GHF/corntroller-hw/TODO/todo.txt

TODO
====

4/16/2012
---------
+ fix PWM input labels

4/05/2012
---------
+ need more:
	10k 0603
	4.7uF 0603 >=10V
	4.7k 0603
	9.1k 0603
	ACS714

3/27/2012
---------
+ update board docs & art
+ panelize TinyHusk

3/20/2012
---------
schematic fixes:
+ remove MAX881R
+ remove current sense op amps; just use a divider (9.1k & 4.7k)
+ add NC trace jumper for DVDD to REF
+ widen DRV8302 footprint

3/17/2012
---------
tinyhusk v2.0:
+ airwire MAX881R pin 7 to -UB
+ fix inverting amps into buffers
+ replace (1k + 1k) & 330R divider with (10k + 10k) & 10k
+ bridge DVDD to REF
+ check all DRV8302 joints

minicob v2.0:
+ desolder radio, solder in bluetooth
