GHF/corntroller-hw/MiniCob/babycorntroller.bmp

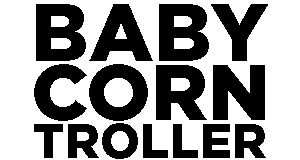
MiniCob/babycorntroller.bmp
