GHF/corntroller-hw/MiniCob/vanity.bmp

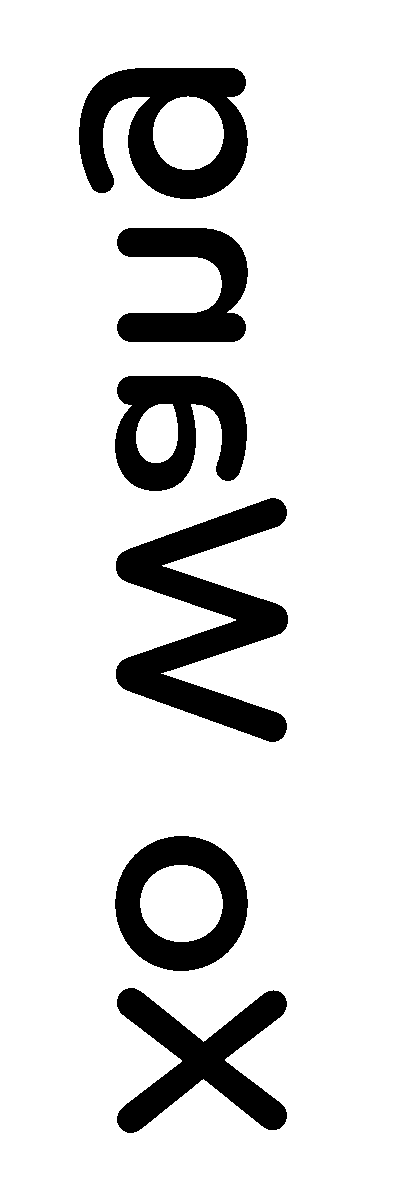
MiniCob/vanity.bmp
