GHF/corntroller-hw/TinyHusk/babycorntroller.bmp

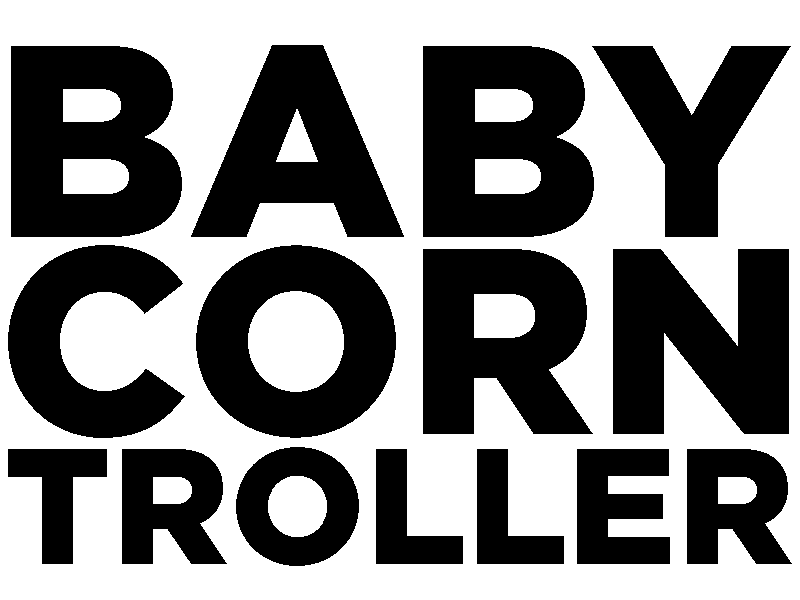
TinyHusk/babycorntroller.bmp
