GHF/corntroller-hw/TODO/negLDOfix.png

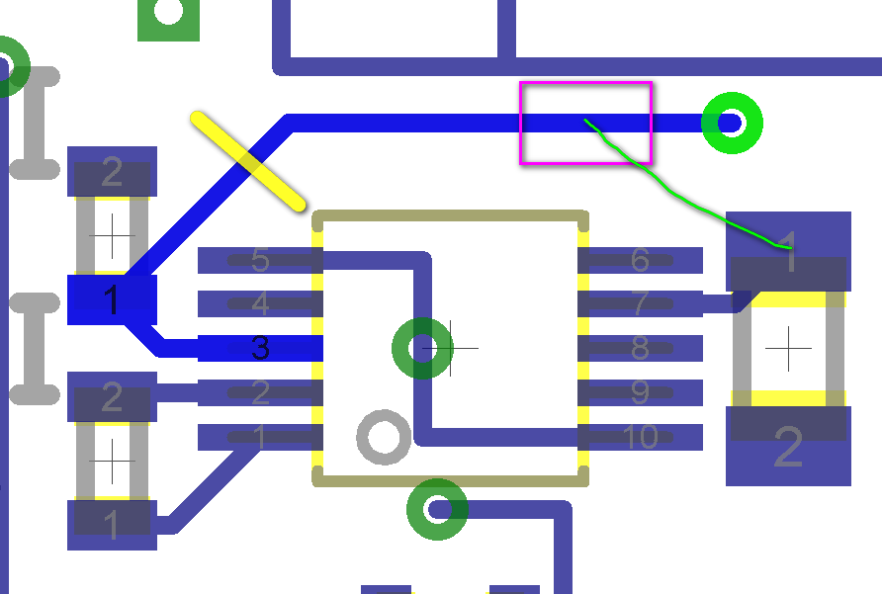
TODO/negLDOfix.png
