GHF/corntroller-hw/TODO/opAmpFix.png

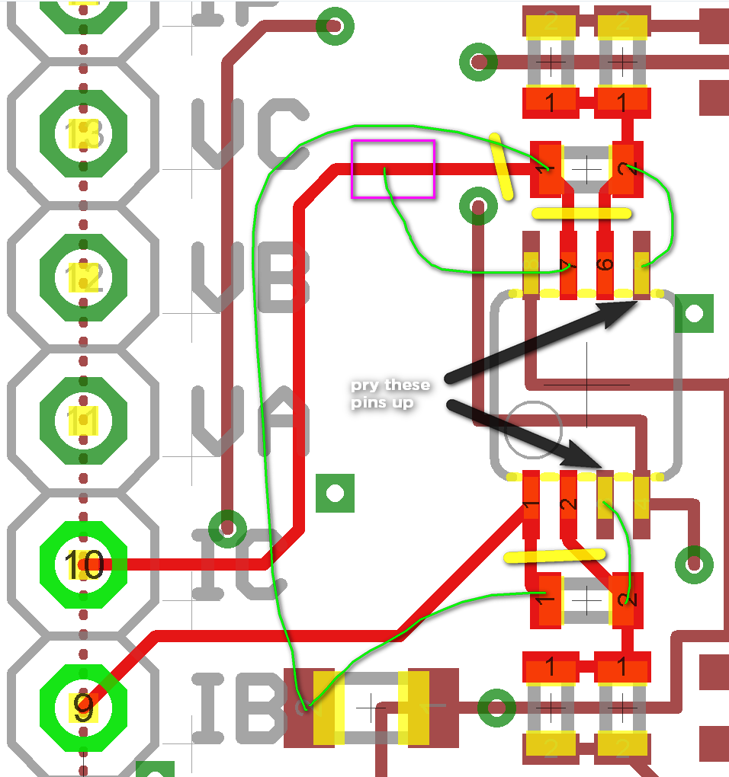
TODO/opAmpFix.png
