GHF/corntroller-hw/TODO/radioFootprint.png

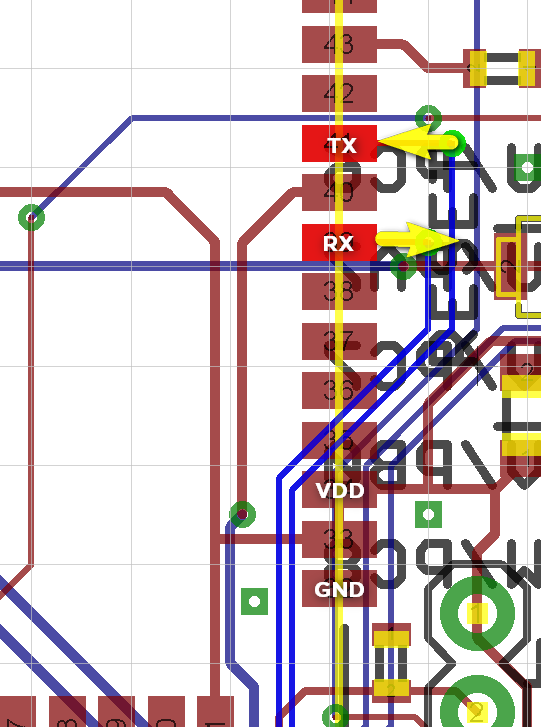
TODO/radioFootprint.png
