GHF/corntroller-hw/TinyHusk/TinyHusk.brd

## EAGLE design TinyHusk/TinyHusk.brd (2012-04-16)

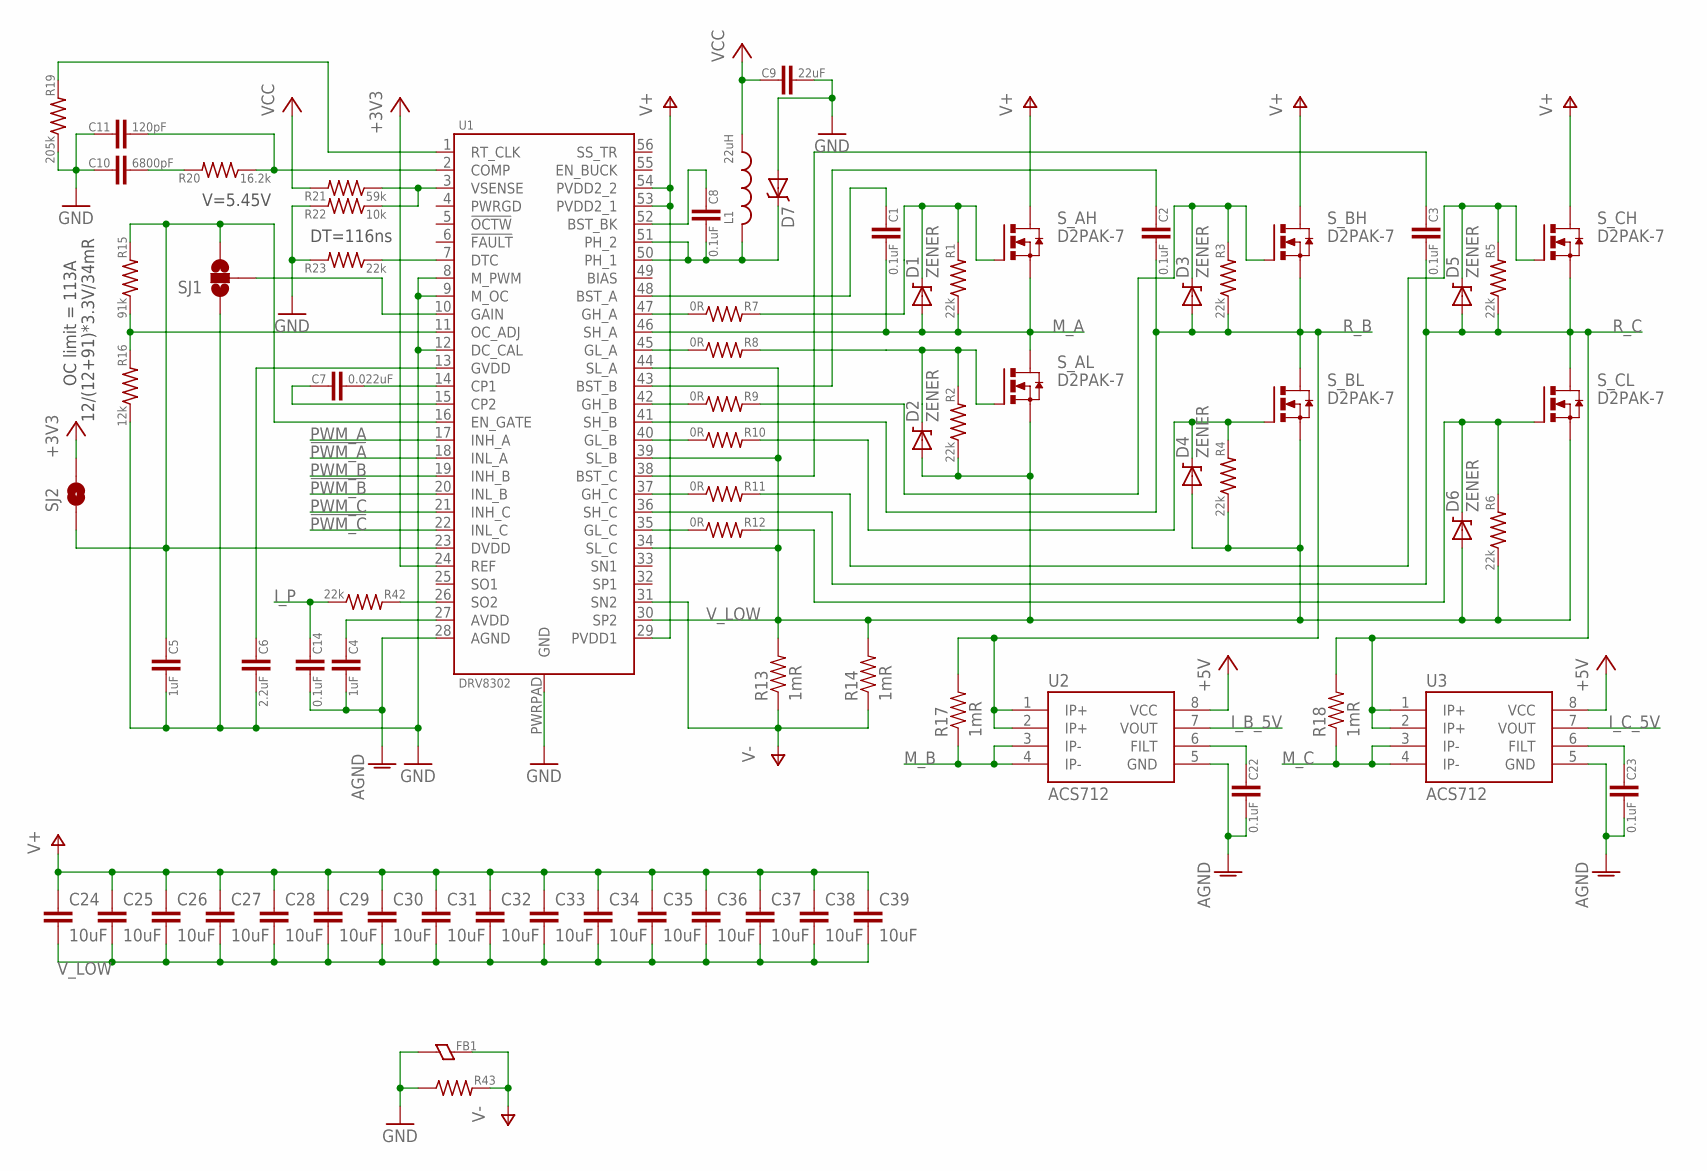
[picture p7: schematic TinyHusk.sch, sheet 1]

Parts:
C1, C2, C3, C8, C14, C22, C23: 0.1uF; 0603
C4, C5: 1uF; 0603
C6: 2.2uF; 0603
C7: 0.022uF; 0603
C9: 22uF; 0805
C10: 6800pF; 0603
C11: 120pF; 0603
C24, C25, C26, C27, C28, C29, C30, C31, C32, C33, C34, C35, C36, C37, C38, C39: 10uF; 1210
D1, D2, D3, D4, D5, D6: ZENER; SOD-323
D7: DIODE-SCHOTTKY_; SMA-DIODE
FB1: FERRITE0603; 0603
L1: 22uH; TAIYO-YUDEN_NR50
R1, R2, R3, R4, R5, R6, R23, R42: 22k; 0603
R7, R8, R9, R10, R11, R12: 0R; 0603
R13, R14, R17, R18: 1mR; R2512
R15: 91k; 0603
R16: 12k; 0603
R19: 205k; 0603
R20: 16.2k; 0603
R21: 59k; 0603
R22: 10k; 0603
R43: R0603; 0603
SJ1: SOLDERJUMPER_2WAYS; SJ_X
SJ2: SOLDERJUMPERTRACE; SJ_2S-TRACE
S_AH: D2PAK-7
S_AL: D2PAK-7
S_BH: D2PAK-7
S_BL: D2PAK-7
S_CH: D2PAK-7
S_CL: D2PAK-7
U1: DRV8302; HTSSOP-56
U2, U3: ACS712; SO08

Connections:
!PWM_A: U1.18 (INL_A); also elsewhere on the board
!PWM_B: U1.20 (INL_B); also elsewhere on the board
!PWM_C: U1.22 (INL_C); also elsewhere on the board
+3V3: SJ2.2, U1.24 (REF); also elsewhere on the board
+5V: U2.8 (VCC), U3.8 (VCC); also elsewhere on the board
AGND: C4.2, C14.2, C22.2, C23.2, U1.28 (AGND), U2.5 (GND), U3.5 (GND); also elsewhere on the board
GND: C5.2, C6.2, C9.2, C10.1, C11.1, D7.A, FB1.1, R16.1, R19.1, R22.2, R23.2, R43.1, SJ1.1, U1.8 (M_PWM), U1.9 (M_OC), U1.12 (DC_CAL), U1.PWRPAD (GND); also elsewhere on the board
I_B_5V: U2.7 (VOUT); also elsewhere on the board
I_C_5V: U3.7 (VOUT); also elsewhere on the board
I_P: C14.1, R42.1; also elsewhere on the board
M_A: C1.2, D1.2 (A), R1.1, S_AH.2 (S), S_AH.3 (S), S_AH.5 (S), S_AH.6 (S), S_AH.7 (S), S_AL.4 (D), U1.46 (SH_A); also elsewhere on the board
M_B: R17.1, U2.3 (IP-), U2.4 (IP-)
M_C: R18.1, U3.3 (IP-), U3.4 (IP-)
unnamed: R7.1, U1.47 (GH_A)
unnamed: R8.1, U1.45 (GL_A)
unnamed: R42.2, U1.26 (SO2)
unnamed: D1.1 (C), R1.2, R7.2, S_AH.1 (G)
unnamed: D3.1 (C), R3.2, R9.2, S_BH.1 (G)
unnamed: C22.1, U2.6 (FILT)
unnamed: D4.1 (C), R4.2, R10.2, S_BL.1 (G)
unnamed: R21.1, R22.1, U1.3 (VSENSE)
unnamed: D5.1 (C), R5.2, R11.2, S_CH.1 (G)
unnamed: C23.1, U3.6 (FILT)
unnamed: D6.1 (C), R6.2, R12.2, S_CL.1 (G)
unnamed: R9.1, U1.42 (GH_B)
unnamed: C1.1, U1.48 (BST_A)
unnamed: C2.1, U1.43 (BST_B)
unnamed: C3.1, U1.38 (BST_C)
unnamed: R10.1, U1.40 (GL_B)
unnamed: R11.1, U1.37 (GH_C)
unnamed: D2.1 (C), R2.2, R8.2, S_AL.1 (G)
unnamed: R12.1, U1.35 (GL_C)
unnamed: SJ1.2, U1.10 (GAIN)
unnamed: C5.1, R15.2, SJ1.3, SJ2.1, U1.16 (EN_GATE), U1.23 (DVDD)
unnamed: C4.1, U1.27 (AVDD)
unnamed: C6.1, U1.13 (GVDD)
unnamed: C7.2, U1.14 (CP1)
unnamed: C7.1, U1.15 (CP2)
unnamed: R15.1, R16.2, U1.11 (OC_ADJ)
unnamed: C8.2, D7.C, L1.P$2 (2), U1.50 (PH_1), U1.51 (PH_2)
unnamed: C8.1, U1.52 (BST_BK)
unnamed: C11.2, R20.1, U1.2 (COMP)
unnamed: C10.2, R20.2
unnamed: R19.2, U1.1 (RT_CLK)
unnamed: R23.1, U1.7 (DTC)
PWM_A: U1.17 (INH_A); also elsewhere on the board
PWM_B: U1.19 (INH_B); also elsewhere on the board
PWM_C: U1.21 (INH_C); also elsewhere on the board
R_B: C2.2, D3.2 (A), R3.1, R17.2, S_BH.2 (S), S_BH.3 (S), S_BH.5 (S), S_BH.6 (S), S_BH.7 (S), S_BL.4 (D), U1.41 (SH_B), U2.1 (IP+), U2.2 (IP+); also elsewhere on the board
R_C: C3.2, D5.2 (A), R5.1, R18.2, S_CH.2 (S), S_CH.3 (S), S_CH.5 (S), S_CH.6 (S), S_CH.7 (S), S_CL.4 (D), U1.36 (SH_C), U3.1 (IP+), U3.2 (IP+); also elsewhere on the board
V+: C24.1, C25.1, C26.1, C27.1, C28.1, C29.1, C30.1, C31.1, C32.1, C33.1, C34.1, C35.1, C36.1, C37.1, C38.1, C39.1, S_AH.4 (D), S_BH.4 (D), S_CH.4 (D), U1.29 (PVDD1), U1.53 (PVDD2_1), U1.54 (PVDD2_2); also elsewhere on the board
V-: FB1.2, R13.1, R14.1, R43.2, U1.31 (SN2); also elsewhere on the board
VCC: C9.1, L1.P$1 (1), R21.2; also elsewhere on the board
V_LOW: C24.2, C25.2, C26.2, C27.2, C28.2, C29.2, C30.2, C31.2, C32.2, C33.2, C34.2, C35.2, C36.2, C37.2, C38.2, C39.2, D2.2 (A), D4.2 (A), D6.2 (A), R2.1, R4.1, R6.1, R13.2, R14.2, S_AL.2 (S), S_AL.3 (S), S_AL.5 (S), S_AL.6 (S), S_AL.7 (S), S_BL.2 (S), S_BL.3 (S), S_BL.5 (S), S_BL.6 (S), S_BL.7 (S), S_CL.2 (S), S_CL.3 (S), S_CL.5 (S), S_CL.6 (S), S_CL.7 (S), U1.30 (SP2), U1.34 (SL_C), U1.39 (SL_B), U1.44 (SL_A)

Notes on the sheet:
OC limit = 113A
12/(12+91)*3.3V/34mR
V=5.45V
DT=116ns

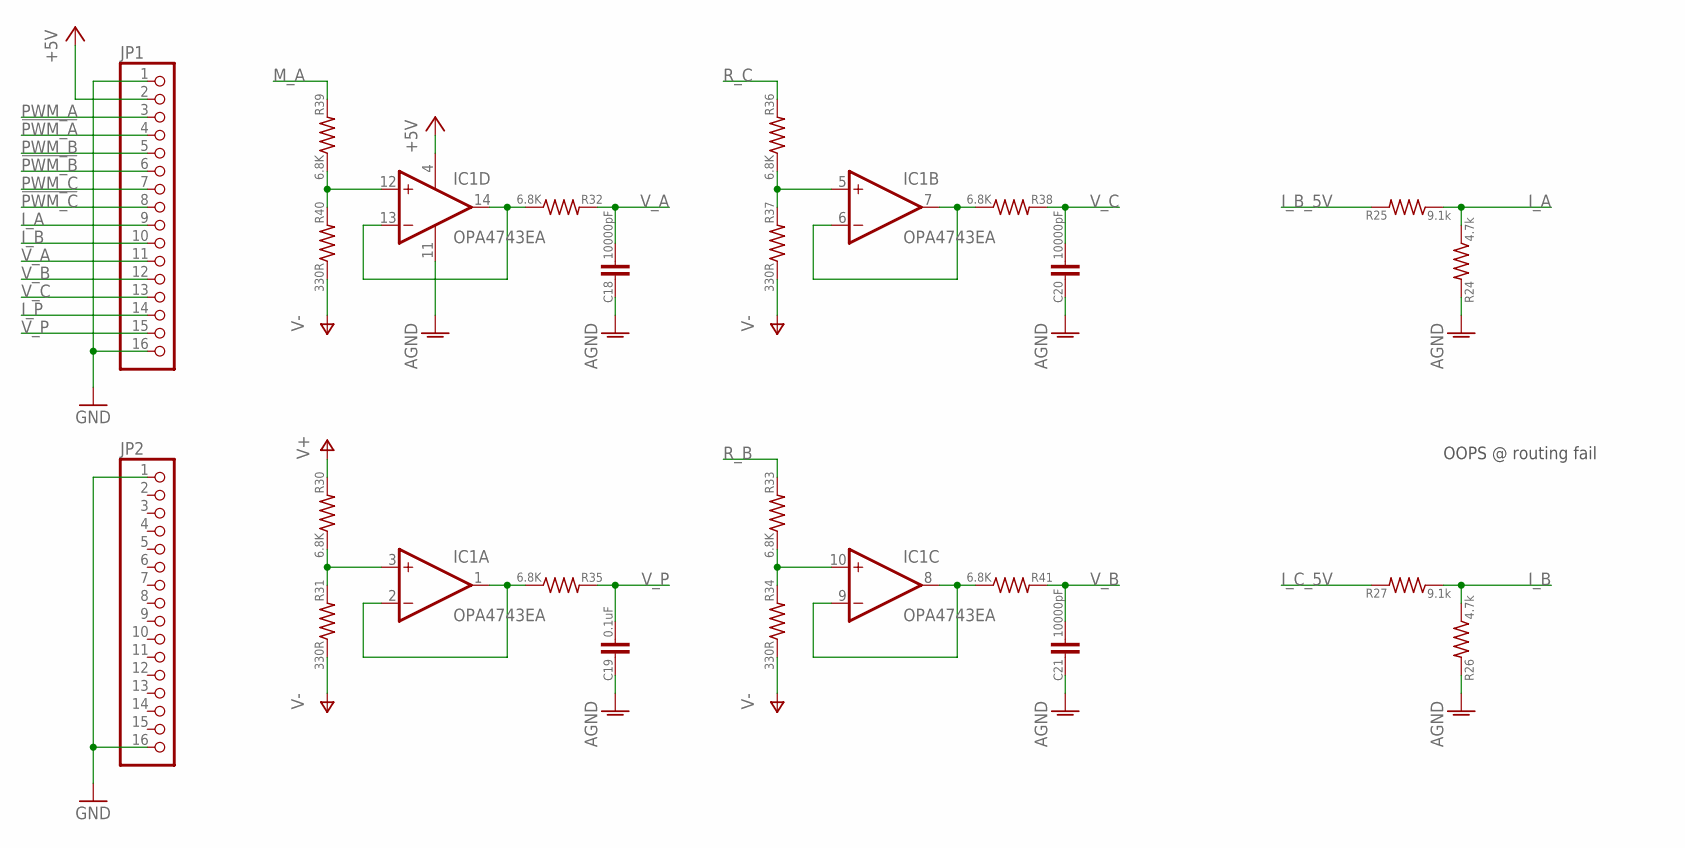
[picture p8: schematic TinyHusk.sch, sheet 2]

Parts:
C18, C20, C21: 10000pF; 0603
C19: 0.1uF; 0603
IC1: OPA4743EA; TSSOP14
JP1, JP2: PINHD-1X16_2.54-S; 1X16-S
R24, R26: 4.7k; 0603
R25, R27: 9.1k; 0603
R30, R32, R33, R35, R36, R38, R39, R41: 6.8K; 0603
R31, R34, R37, R40: 330R; 0603

Connections:
!PWM_A: JP1.4; also elsewhere on the board
!PWM_B: JP1.6; also elsewhere on the board
!PWM_C: JP1.8; also elsewhere on the board
+5V: IC1.4 (V+), JP1.2; also elsewhere on the board
AGND: C18.1, C19.1, C20.1, C21.1, IC1.11 (V-), R24.2, R26.2; also elsewhere on the board
GND: JP1.1, JP1.16, JP2.1, JP2.16; also elsewhere on the board
I_A: JP1.9, R24.1, R25.1
I_B: JP1.10, R26.1, R27.1
I_B_5V: R25.2; also elsewhere on the board
I_C_5V: R27.2; also elsewhere on the board
I_P: JP1.14; also elsewhere on the board
M_A: R39.2; also elsewhere on the board
unnamed: IC1.1 (OUT), IC1.2 (-IN), R35.1
unnamed: IC1.6 (-IN), IC1.7 (OUT), R38.1
unnamed: IC1.8 (OUT), IC1.9 (-IN), R41.1
unnamed: IC1.13 (-IN), IC1.14 (OUT), R32.1
unnamed: IC1.3 (+IN), R30.1, R31.2
unnamed: IC1.10 (+IN), R33.1, R34.2
unnamed: IC1.5 (+IN), R36.1, R37.2
unnamed: IC1.12 (+IN), R39.1, R40.2
PWM_A: JP1.3; also elsewhere on the board
PWM_B: JP1.5; also elsewhere on the board
PWM_C: JP1.7; also elsewhere on the board
R_B: R33.2; also elsewhere on the board
R_C: R36.2; also elsewhere on the board
V+: R30.2; also elsewhere on the board
V-: R31.1, R34.1, R37.1, R40.1; also elsewhere on the board
V_A: C18.2, JP1.11, R32.2
V_B: C21.2, JP1.12, R41.2
V_C: C20.2, JP1.13, R38.2
V_P: C19.2, JP1.15, R35.2

Notes on the sheet:
OOPS @ routing fail

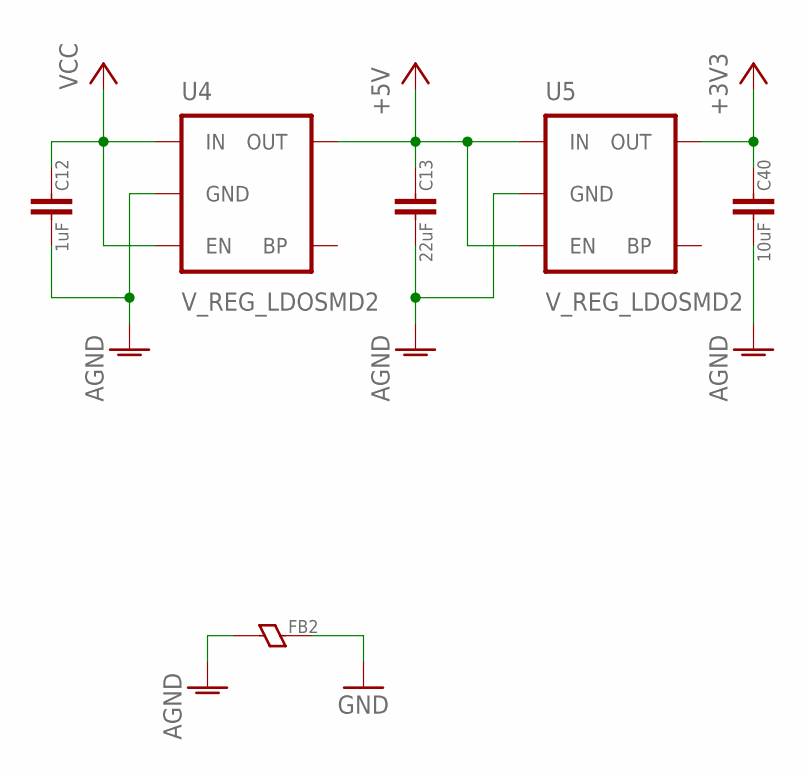
[picture p9: schematic TinyHusk.sch, sheet 3]

Parts:
C12: 1uF; 0603
C13: 22uF; 0805
C40: 10uF; 0603
FB2: FERRITE0603; 0603
U4, U5: V_REG_LDOSMD2; SC70

Connections:
+3V3: C40.1, U5.5 (OUT); also elsewhere on the board
+5V: C13.1, U4.5 (OUT), U5.1 (IN), U5.3 (EN); also elsewhere on the board
AGND: C12.2, C13.2, C40.2, FB2.1, U4.2 (GND), U5.2 (GND); also elsewhere on the board
GND: FB2.2; also elsewhere on the board
VCC: C12.1, U4.1 (IN), U4.3 (EN); also elsewhere on the board

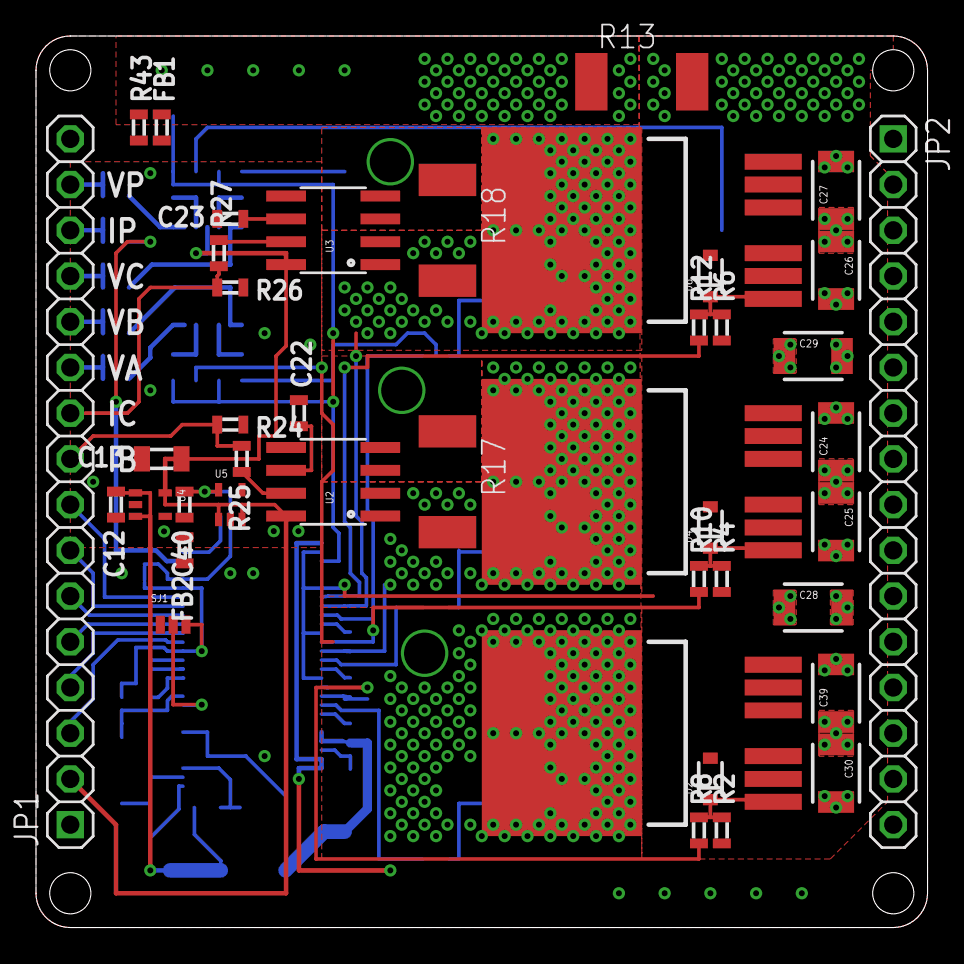
[picture p10: board TinyHusk.brd from above]

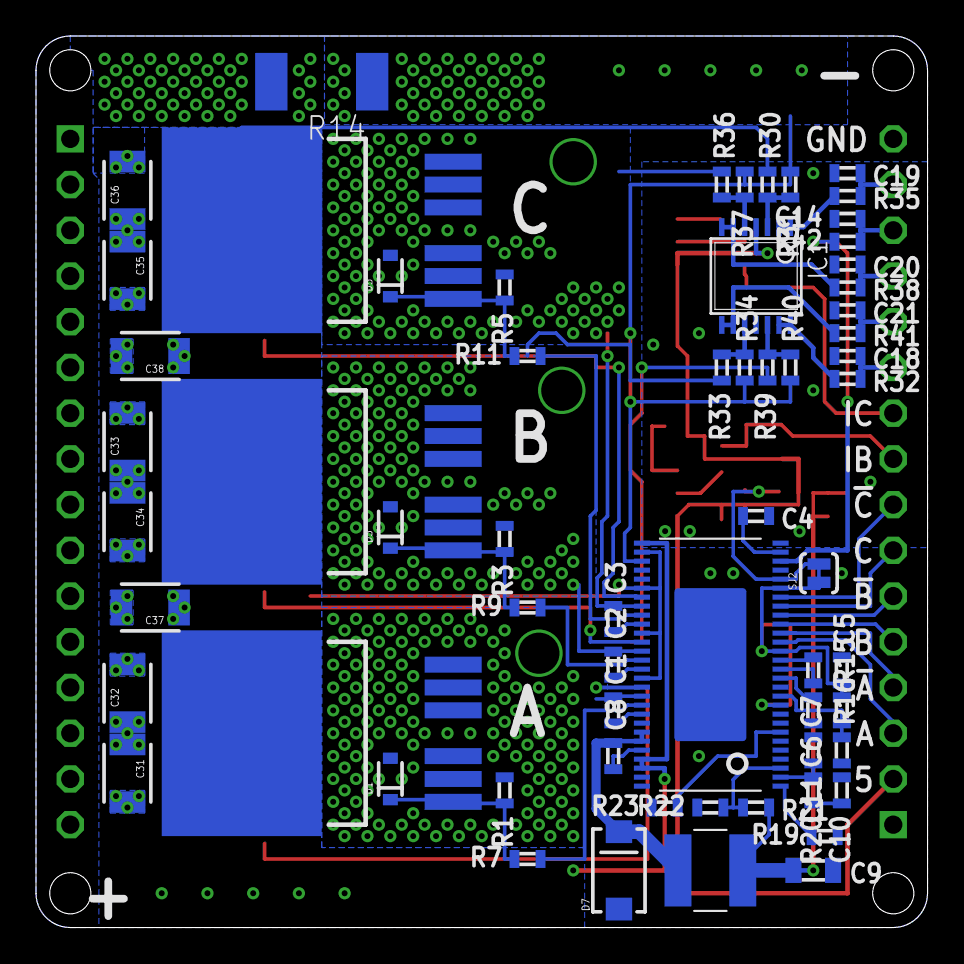
[picture p11: board TinyHusk.brd from below]

Board: 2 copper layers, 49.5 x 49.5 mm, 104 parts (62 on the bottom side), 68 nets.
