GHF/corntroller-hw/MiniCob/MiniCob.brd

## EAGLE design MiniCob/MiniCob.brd (2012-03-20)

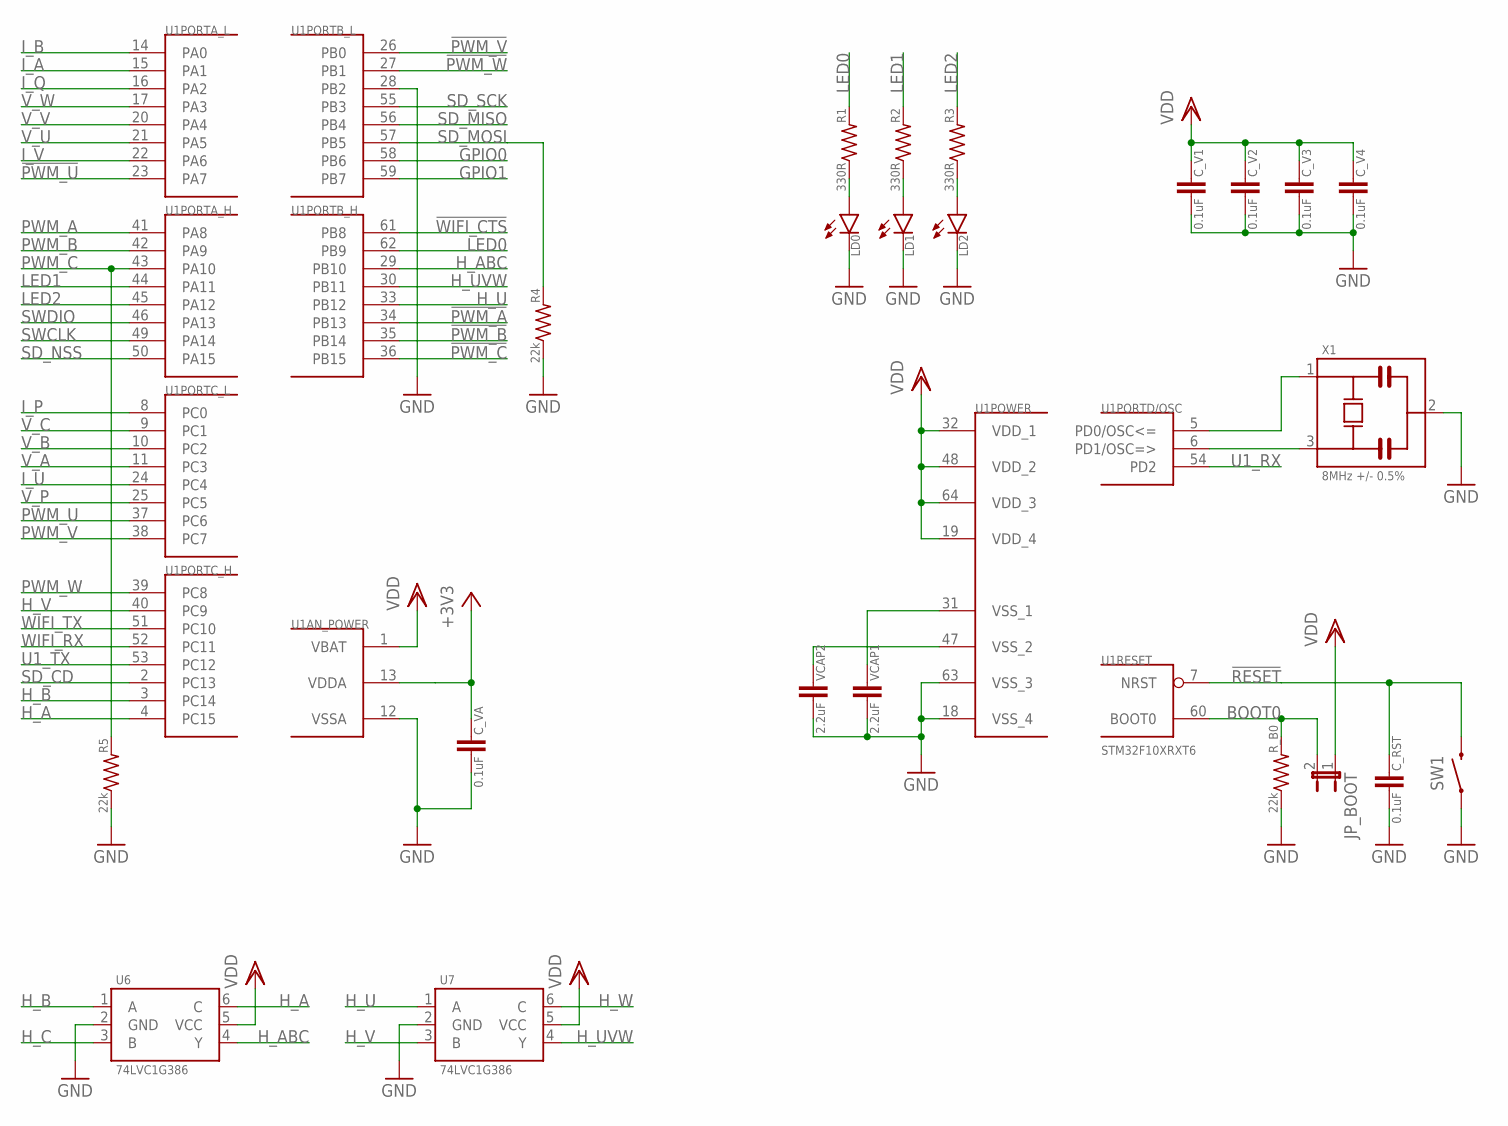
[picture p12: schematic MiniCob.sch, sheet 1]

Parts:
C_RST: 0.1uF; 0603
C_V1, C_V2, C_V3, C_V4: 0.1uF; 0603
C_VA: 0.1uF; 0603
JP_BOOT: JUMPER-2PTH; 1X02
LD0, LD1, LD2: LED0805; 0805_POL
R1, R2, R3: 330R; 0603
R4, R5: 22k; 0603
R_B0: 22k; 0603
SW1: SWITCH_SPST-NO; B3U-1000P
U1: STM32F10XRXT6; TQFP64
U6, U7: 74LVC1G386; SC-70
VCAP1, VCAP2: 2.2uF; 0603
X1: 8MHz +/- 0.5%; MURATA_CSTCE

Connections:
!PWM_A: U1.34 (PB13); also elsewhere on the board
!PWM_B: U1.35 (PB14); also elsewhere on the board
!PWM_C: U1.36 (PB15); also elsewhere on the board
!PWM_U: U1.23 (PA7); also elsewhere on the board
!PWM_V: U1.26 (PB0); also elsewhere on the board
!PWM_W: U1.27 (PB1); also elsewhere on the board
!RESET: C_RST.1, SW1.2, U1.7 (NRST); also elsewhere on the board
!WIFI_CTS: U1.61 (PB8); also elsewhere on the board
+3V3: C_VA.1, U1.13 (VDDA); also elsewhere on the board
BOOT0: JP_BOOT.2, R_B0.2, U1.60 (BOOT0)
GND: C_RST.2, C_V1.2, C_V2.2, C_V3.2, C_V4.2, C_VA.2, LD0.- (C), LD1.- (C), LD2.- (C), R4.1, R5.1, R_B0.1, SW1.1, U1.12 (VSSA), U1.18 (VSS_4), U1.28 (PB2), U1.63 (VSS_3), U6.2 (GND), U7.2 (GND), VCAP1.2, VCAP2.2, X1.2; also elsewhere on the board
GPIO0: U1.58 (PB6); also elsewhere on the board
GPIO1: U1.59 (PB7); also elsewhere on the board
H_A: U1.4 (PC15), U6.6 (C); also elsewhere on the board
H_ABC: U1.29 (PB10), U6.4 (Y)
H_B: U1.3 (PC14), U6.1 (A); also elsewhere on the board
H_C: U6.3 (B); also elsewhere on the board
H_U: U1.33 (PB12), U7.1 (A); also elsewhere on the board
H_UVW: U1.30 (PB11), U7.4 (Y)
H_V: U1.40 (PC9), U7.3 (B); also elsewhere on the board
H_W: U7.6 (C); also elsewhere on the board
I_A: U1.15 (PA1); also elsewhere on the board
I_B: U1.14 (PA0); also elsewhere on the board
I_P: U1.8 (PC0); also elsewhere on the board
I_Q: U1.16 (PA2); also elsewhere on the board
I_U: U1.24 (PC4); also elsewhere on the board
I_V: U1.22 (PA6); also elsewhere on the board
LED0: R1.2, U1.62 (PB9)
LED1: R2.2, U1.44 (PA11)
LED2: R3.2, U1.45 (PA12)
unnamed: U1.6 (PD1/OSC=>), X1.3
unnamed: U1.5 (PD0/OSC<=), X1.1
unnamed: U1.47 (VSS_2), VCAP2.1
unnamed: U1.31 (VSS_1), VCAP1.1
unnamed: LD0.+ (A), R1.1
unnamed: LD1.+ (A), R2.1
unnamed: LD2.+ (A), R3.1
PWM_A: U1.41 (PA8); also elsewhere on the board
PWM_B: U1.42 (PA9); also elsewhere on the board
PWM_C: R5.2, U1.43 (PA10); also elsewhere on the board
PWM_U: U1.37 (PC6); also elsewhere on the board
PWM_V: U1.38 (PC7); also elsewhere on the board
PWM_W: U1.39 (PC8); also elsewhere on the board
SD_CD: U1.2 (PC13); also elsewhere on the board
SD_MISO: U1.56 (PB4); also elsewhere on the board
SD_MOSI: R4.2, U1.57 (PB5); also elsewhere on the board
SD_NSS: U1.50 (PA15); also elsewhere on the board
SD_SCK: U1.55 (PB3); also elsewhere on the board
SWCLK: U1.49 (PA14); also elsewhere on the board
SWDIO: U1.46 (PA13); also elsewhere on the board
U1_RX: U1.54 (PD2); also elsewhere on the board
U1_TX: U1.53 (PC12); also elsewhere on the board
VDD: C_V1.1, C_V2.1, C_V3.1, C_V4.1, JP_BOOT.1, U1.1 (VBAT), U1.19 (VDD_4), U1.32 (VDD_1), U1.48 (VDD_2), U1.64 (VDD_3), U6.5 (VCC), U7.5 (VCC); also elsewhere on the board
V_A: U1.11 (PC3); also elsewhere on the board
V_B: U1.10 (PC2); also elsewhere on the board
V_C: U1.9 (PC1); also elsewhere on the board
V_P: U1.25 (PC5); also elsewhere on the board
V_U: U1.21 (PA5); also elsewhere on the board
V_V: U1.20 (PA4); also elsewhere on the board
V_W: U1.17 (PA3); also elsewhere on the board
WIFI_RX: U1.52 (PC11); also elsewhere on the board
WIFI_TX: U1.51 (PC10); also elsewhere on the board

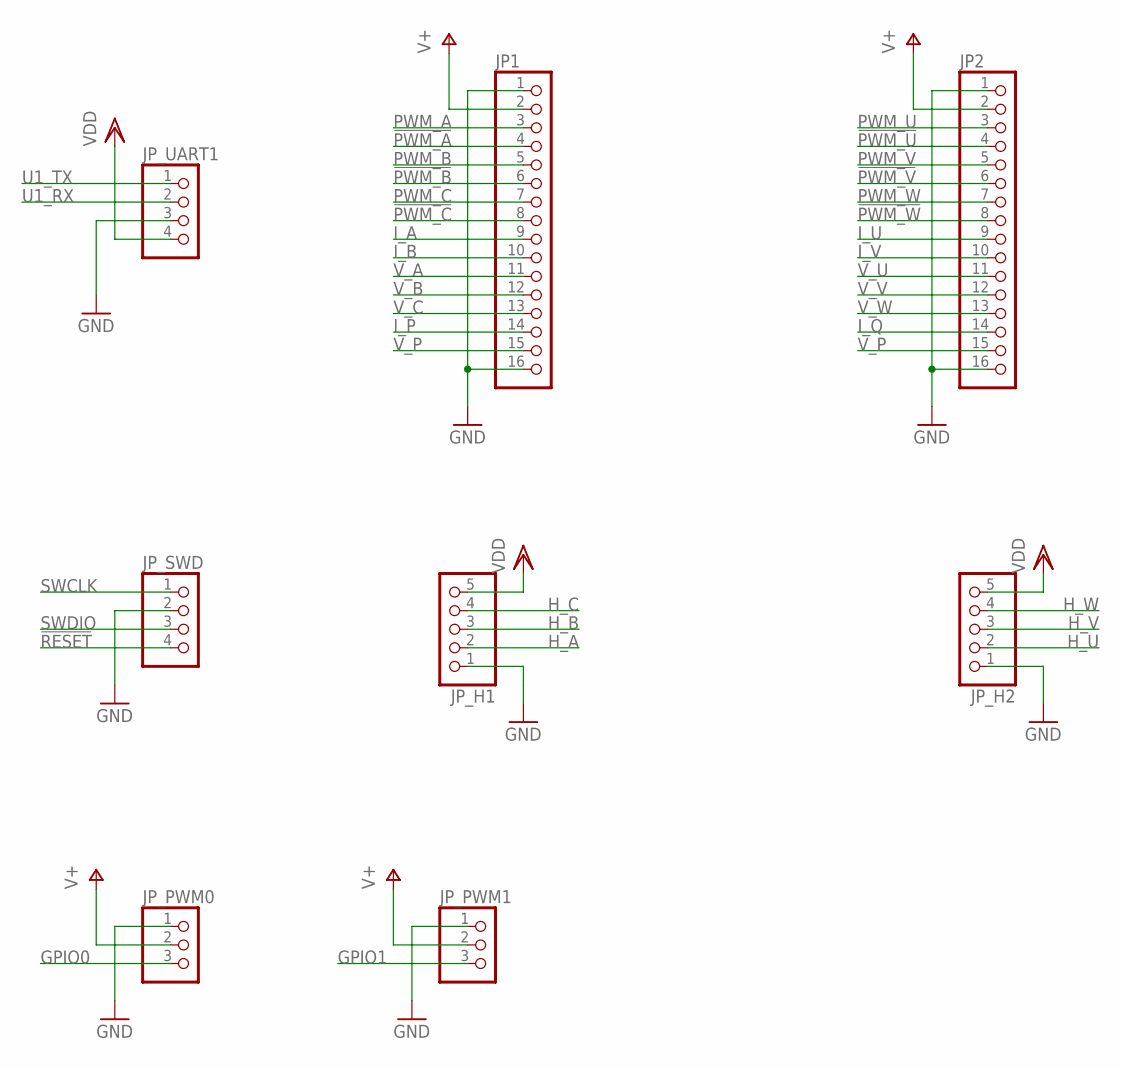
[picture p13: schematic MiniCob.sch, sheet 2]

Parts:
JP1, JP2: PINHD-1X16_2.54-S; 1X16-S
JP_H1, JP_H2: PINHD-1X05_2.54-S; 1X05-S
JP_PWM0, JP_PWM1: PINHD-1X03_2.54-S; 1X03-S
JP_SWD: PINHD-1X04_2.54-S; 1X04-S
JP_UART1: PINHD-1X04_2.54-S; 1X04-S

Connections:
!PWM_A: JP1.4; also elsewhere on the board
!PWM_B: JP1.6; also elsewhere on the board
!PWM_C: JP1.8; also elsewhere on the board
!PWM_U: JP2.4; also elsewhere on the board
!PWM_V: JP2.6; also elsewhere on the board
!PWM_W: JP2.8; also elsewhere on the board
!RESET: JP_SWD.4; also elsewhere on the board
GND: JP1.1, JP1.16, JP2.1, JP2.16, JP_H1.1, JP_H2.1, JP_PWM0.1, JP_PWM1.1, JP_SWD.2, JP_UART1.3; also elsewhere on the board
GPIO0: JP_PWM0.3; also elsewhere on the board
GPIO1: JP_PWM1.3; also elsewhere on the board
H_A: JP_H1.2; also elsewhere on the board
H_B: JP_H1.3; also elsewhere on the board
H_C: JP_H1.4; also elsewhere on the board
H_U: JP_H2.2; also elsewhere on the board
H_V: JP_H2.3; also elsewhere on the board
H_W: JP_H2.4; also elsewhere on the board
I_A: JP1.9; also elsewhere on the board
I_B: JP1.10; also elsewhere on the board
I_P: JP1.14; also elsewhere on the board
I_Q: JP2.14; also elsewhere on the board
I_U: JP2.9; also elsewhere on the board
I_V: JP2.10; also elsewhere on the board
PWM_A: JP1.3; also elsewhere on the board
PWM_B: JP1.5; also elsewhere on the board
PWM_C: JP1.7; also elsewhere on the board
PWM_U: JP2.3; also elsewhere on the board
PWM_V: JP2.5; also elsewhere on the board
PWM_W: JP2.7; also elsewhere on the board
SWCLK: JP_SWD.1; also elsewhere on the board
SWDIO: JP_SWD.3; also elsewhere on the board
U1_RX: JP_UART1.2; also elsewhere on the board
U1_TX: JP_UART1.1; also elsewhere on the board
V+: JP1.2, JP2.2, JP_PWM0.2, JP_PWM1.2; also elsewhere on the board
VDD: JP_H1.5, JP_H2.5, JP_UART1.4; also elsewhere on the board
V_A: JP1.11; also elsewhere on the board
V_B: JP1.12; also elsewhere on the board
V_C: JP1.13; also elsewhere on the board
V_P: JP1.15, JP2.15; also elsewhere on the board
V_U: JP2.11; also elsewhere on the board
V_V: JP2.12; also elsewhere on the board
V_W: JP2.13; also elsewhere on the board

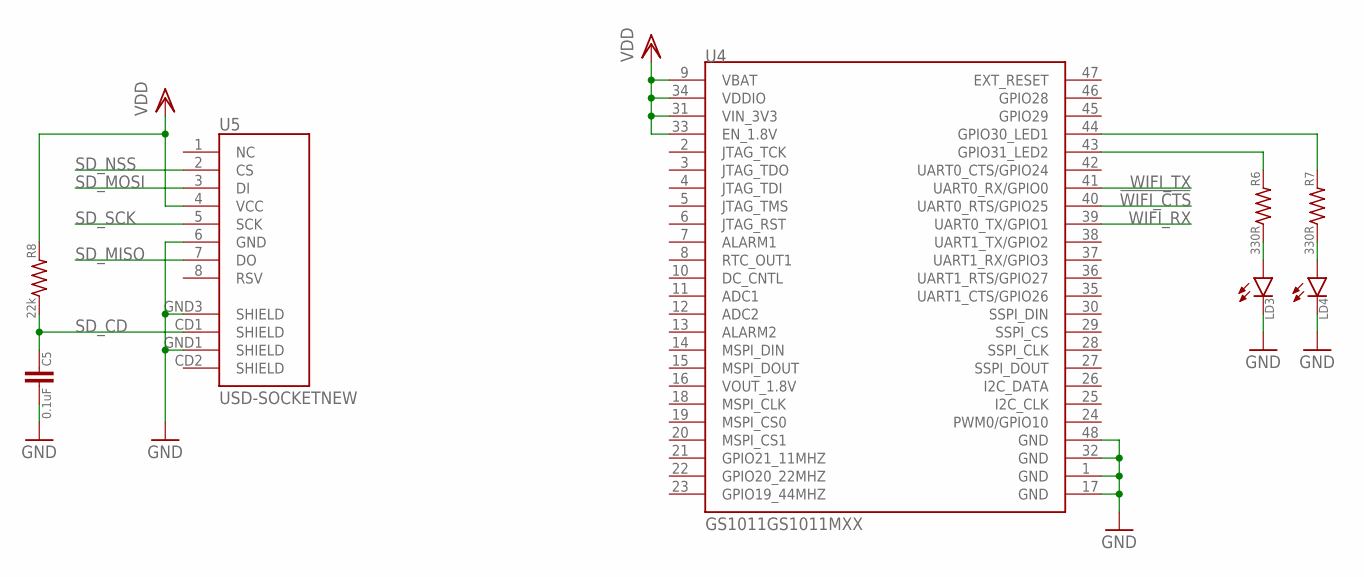
[picture p14: schematic MiniCob.sch, sheet 3]

Parts:
C5: 0.1uF; 0603
LD3, LD4: LED0805; 0805_POL
R6, R7: 330R; 0603
R8: 22k; 0603
U4: GS1011GS1011MXX; GS1011MXX
U5: USD-SOCKETNEW; MICRO-SD-SOCKET-PP

Connections:
!WIFI_CTS: U4.40 (UART0_RTS/GPIO25); also elsewhere on the board
GND: C5.2, LD3.- (C), LD4.- (C), U4.1 (GND), U4.17 (GND), U4.32 (GND), U4.48 (GND), U5.6 (GND), U5.GND1 (SHIELD), U5.GND3 (SHIELD); also elsewhere on the board
unnamed: R7.2, U4.44 (GPIO30_LED1)
unnamed: R6.2, U4.43 (GPIO31_LED2)
unnamed: LD3.+ (A), R6.1
unnamed: LD4.+ (A), R7.1
SD_CD: C5.1, R8.1, U5.CD1 (SHIELD); also elsewhere on the board
SD_MISO: U5.7 (DO); also elsewhere on the board
SD_MOSI: U5.3 (DI); also elsewhere on the board
SD_NSS: U5.2 (CS); also elsewhere on the board
SD_SCK: U5.5 (SCK); also elsewhere on the board
VDD: R8.2, U4.9 (VBAT), U4.31 (VIN_3V3), U4.33 (EN_1.8V), U4.34 (VDDIO), U5.4 (VCC); also elsewhere on the board
WIFI_RX: U4.39 (UART0_TX/GPIO1); also elsewhere on the board
WIFI_TX: U4.41 (UART0_RX/GPIO0); also elsewhere on the board

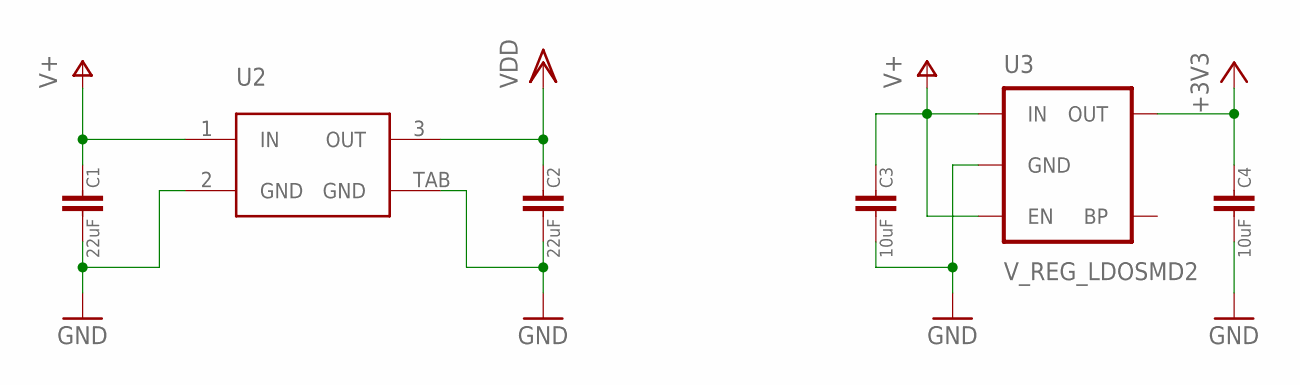
[picture p15: schematic MiniCob.sch, sheet 4]

Parts:
C1, C2: 22uF; 0805
C3, C4: 10uF; 0805
U2: MCP1826S; SOT223-3L
U3: V_REG_LDOSMD2; SC70

Connections:
+3V3: C4.1, U3.5 (OUT); also elsewhere on the board
GND: C1.2, C2.2, C3.2, C4.2, U2.2 (GND), U2.TAB (GND), U3.2 (GND); also elsewhere on the board
V+: C1.1, C3.1, U2.1 (IN), U3.1 (IN), U3.3 (EN); also elsewhere on the board
VDD: C2.1, U2.3 (OUT); also elsewhere on the board

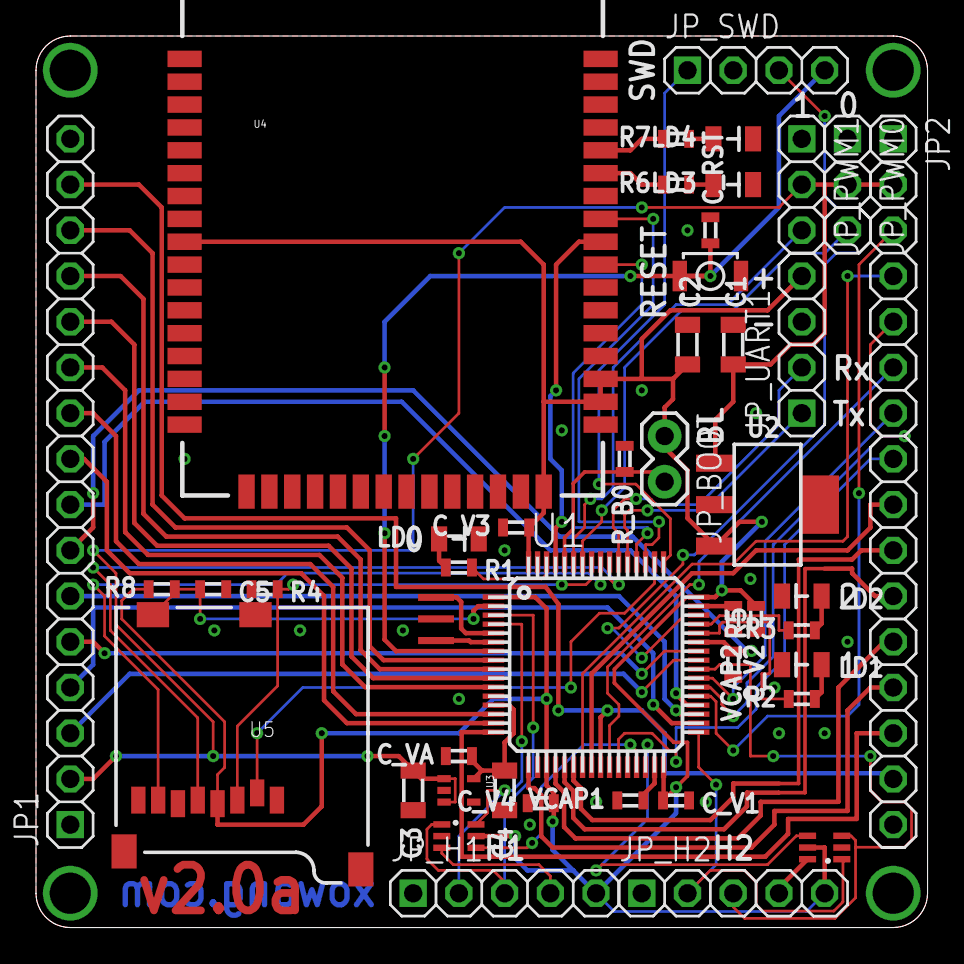
[picture p16: board MiniCob.brd from above]

Board: 2 copper layers, 49.5 x 49.5 mm, 45 parts (0 on the bottom side), 67 nets.
