GHF/corntroller-hw/cornMerge/cornMerge.brd

## EAGLE design cornMerge/cornMerge.brd (2012-04-02)

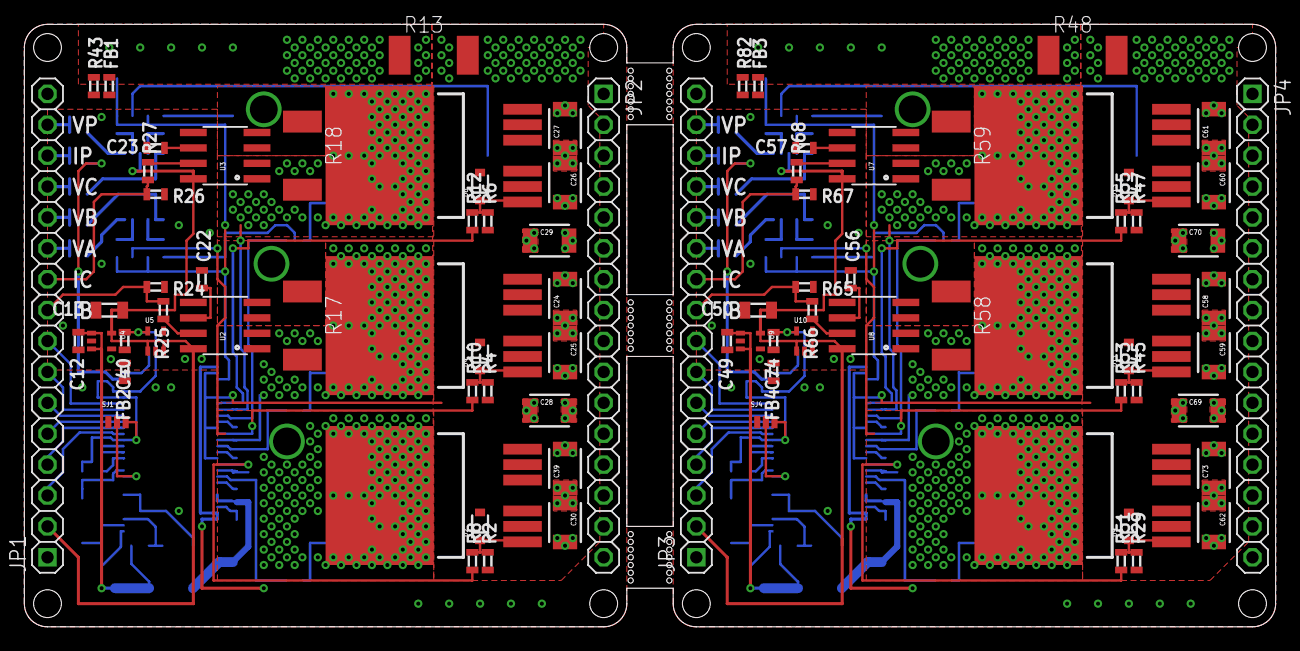
[picture p17: board cornMerge.brd from above]

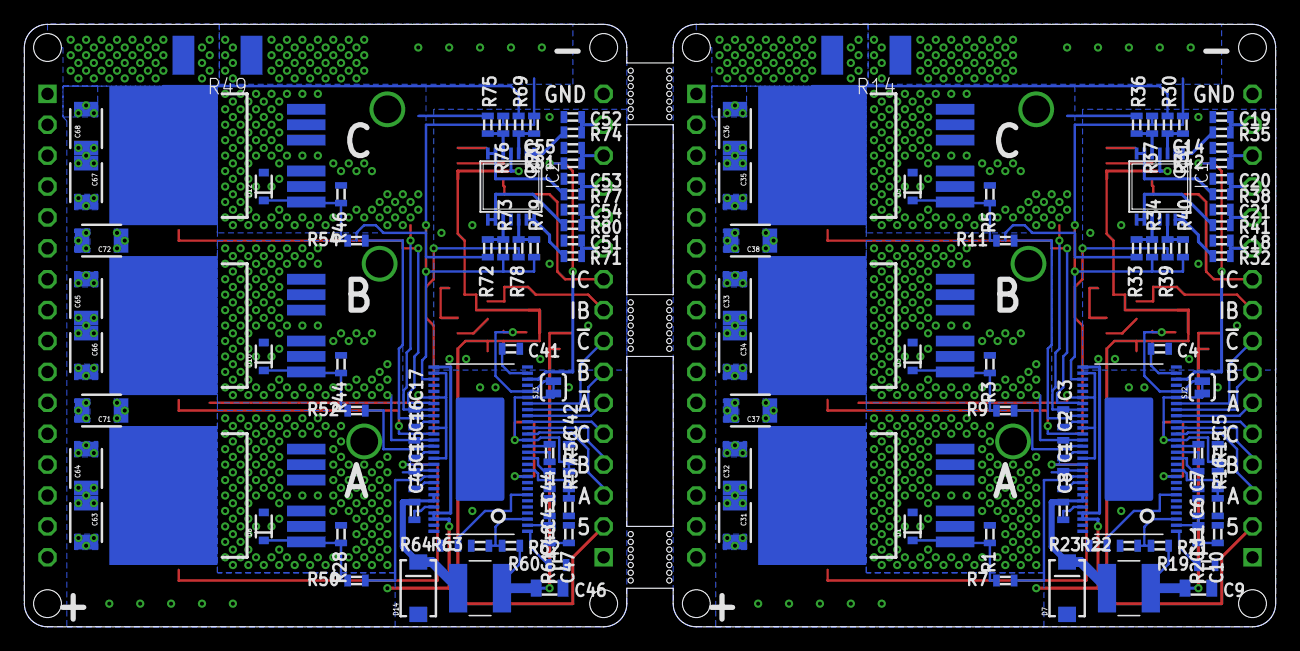
[picture p18: board cornMerge.brd from below]

Board: 2 copper layers, 102.9 x 49.5 mm, 208 parts (124 on the bottom side), 136 nets.

Parts:
C1, C2, C3, C8, C14, C15, C16, C17, C19, C22, C23, C45, C52, C55, C56, C57: 0.1uF; 0603
C4, C5, C12, C41, C42, C49: 1uF; 0603
C6, C43: 2.2uF; 0603
C7, C44: 0.022uF; 0603
C9, C13, C46, C50: 22uF; 0805
C10, C47: 6800pF; 0603
C11, C48: 120pF; 0603
C18, C20, C21, C51, C53, C54: 10000pF; 0603
C24, C25, C26, C27, C28, C29, C30, C31, C32, C33, C34, C35, C36, C37, C38, C39, C58, C59, C60, C61, C62, C63, C64, C65, C66, C67, C68, C69, C70, C71, C72, C73: 10uF; 1210
C40, C74: 10uF; 0603
D1, D2, D3, D4, D5, D6, D8, D9, D10, D11, D12, D13: ZENER; SOD-323
D7, D14: SMA-DIODE
FB1, FB2, FB3, FB4: 0603
IC1, IC2: OPA4743EA; TSSOP14
JP1, JP2, JP3, JP4: 1X16-S
L1, L2: 22uH; TAIYO-YUDEN_NR50
R1, R2, R3, R4, R5, R6, R23, R28, R29, R42, R44, R45, R46, R47, R64, R81: 22k; 0603
R7, R8, R9, R10, R11, R12, R50, R51, R52, R53, R54, R55: 0R; 0603
R13, R14, R17, R18, R48, R49, R58, R59: 1mR; R2512
R15, R56: 91k; 0603
R16, R57: 12k; 0603
R19, R60: 205k; 0603
R20, R61: 16.2k; 0603
R21, R62: 59k; 0603
R22, R63: 10k; 0603
R24, R26, R31, R34, R37, R40, R65, R67, R70, R73, R76, R79: 330R; 0603
R25, R27, R66, R68: 1K; 0603
R30, R32, R33, R35, R36, R38, R39, R41, R69, R71, R72, R74, R75, R77, R78, R80: 6.8K; 0603
R43, R82: 0603
SJ1, SJ4: SJ_X
SJ2, SJ3: SJ_2S-TRACE
S_AH, S_AH1: D2PAK-7
S_AL, S_AL1: D2PAK-7
S_BH, S_BH1: D2PAK-7
S_BL, S_BL1: D2PAK-7
S_CH, S_CH1: D2PAK-7
S_CL, S_CL1: D2PAK-7
U1, U6: DRV8302; HTSSOP-56
U2, U3, U7, U8: ACS712; SO08
U4, U5, U9, U10: V_REG_LDOSMD2; SC70

Connections:
!PWM_A: JP1.4, U1.18
!PWM_A1: JP3.4, U6.18
!PWM_B: JP1.6, U1.20
!PWM_B1: JP3.6, U6.20
!PWM_C: JP1.8, U1.22
!PWM_C1: JP3.8, U6.22
+3V1: C74.1, SJ3.2, U6.24, U10.5
+3V3: C40.1, SJ2.2, U1.24, U5.5
+5V: C13.1, IC1.4, JP1.2, U2.8, U3.8, U4.5, U5.1, U5.3
+5V1: C50.1, IC2.4, JP3.2, U7.8, U8.8, U9.5, U10.1, U10.3
AGND: C4.2, C12.2, C13.2, C14.2, C18.1, C19.1, C20.1, C21.1, C22.2, C23.2, C40.2, FB2.1, IC1.11, R24.2, R26.2, U1.28, U2.5, U3.5, U4.2, U5.2
AGND1: C41.2, C49.2, C50.2, C51.1, C52.1, C53.1, C54.1, C55.2, C56.2, C57.2, C74.2, FB4.1, IC2.11, R65.2, R67.2, U6.28, U7.5, U8.5, U9.2, U10.2
GND: C5.2, C6.2, C9.2, C10.1, C11.1, D7.A, FB1.1, FB2.2, JP1.1, JP1.16, JP2.1, JP2.16, R16.1, R19.1, R22.2, R23.2, R43.1, SJ1.1, U1.8, U1.9, U1.12, U1.PWRPAD
GND2: C42.2, C43.2, C46.2, C47.1, C48.1, D14.A, FB3.1, FB4.2, JP3.1, JP3.16, JP4.1, JP4.16, R57.1, R60.1, R63.2, R64.2, R82.1, SJ4.1, U6.8, U6.9, U6.12, U6.PWRPAD
I_A: JP1.9, R24.1, R25.1
I_A1: JP3.9, R65.1, R66.1
I_B: JP1.10, R26.1, R27.1
I_B1: JP3.10, R67.1, R68.1
I_B_5V: R25.2, U2.7
I_B_5V1: R66.2, U8.7
I_C_5V: R27.2, U3.7
I_C_5V1: R68.2, U7.7
I_P: C14.1, JP1.14, R42.1
I_P1: C55.1, JP3.14, R81.1
M_A: C1.2, D1.2, R1.1, R39.2, S_AH.2, S_AH.3, S_AH.5, S_AH.6, S_AH.7, S_AL.4, U1.46
M_A1: C15.2, D8.2, R28.1, R78.2, S_AH1.2, S_AH1.3, S_AH1.5, S_AH1.6, S_AH1.7, S_AL1.4, U6.46
M_B: R17.1, U2.3, U2.4
M_B1: R58.1, U8.3, U8.4
M_C: R18.1, U3.3, U3.4
M_C1: R59.1, U7.3, U7.4
unnamed: R7.1, U1.47
unnamed: R8.1, U1.45
unnamed: R42.2, U1.26
unnamed: D1.1, R1.2, R7.2, S_AH.1
unnamed: D3.1, R3.2, R9.2, S_BH.1
unnamed: C22.1, U2.6
unnamed: D4.1, R4.2, R10.2, S_BL.1
unnamed: R21.1, R22.1, U1.3
unnamed: D5.1, R5.2, R11.2, S_CH.1
unnamed: C23.1, U3.6
unnamed: D6.1, R6.2, R12.2, S_CL.1
unnamed: R9.1, U1.42
unnamed: C1.1, U1.48
unnamed: C2.1, U1.43
unnamed: C3.1, U1.38
unnamed: R10.1, U1.40
unnamed: R11.1, U1.37
unnamed: D2.1, R2.2, R8.2, S_AL.1
unnamed: R12.1, U1.35
unnamed: SJ1.2, U1.10
unnamed: C5.1, R15.2, SJ1.3, SJ2.1, U1.16, U1.23
unnamed: C4.1, U1.27
unnamed: C6.1, U1.13
unnamed: C7.2, U1.14
unnamed: C7.1, U1.15
unnamed: R15.1, R16.2, U1.11
unnamed: D8.1, R28.2, R50.2, S_AH1.1
unnamed: D10.1, R44.2, R52.2, S_BH1.1
unnamed: C8.2, D7.C, L1.P$2, U1.50, U1.51
unnamed: C8.1, U1.52
unnamed: C11.2, R20.1, U1.2
unnamed: C10.2, R20.2
unnamed: R19.2, U1.1
unnamed: R23.1, U1.7
unnamed: D11.1, R45.2, R53.2, S_BL1.1
unnamed: IC1.1, IC1.2, R35.1
unnamed: D12.1, R46.2, R54.2, S_CH1.1
unnamed: D13.1, R47.2, R55.2, S_CL1.1
unnamed: C15.1, U6.48
unnamed: C16.1, U6.43
unnamed: IC1.6, IC1.7, R38.1
unnamed: IC1.8, IC1.9, R41.1
unnamed: IC1.13, IC1.14, R32.1
unnamed: IC1.3, R30.1, R31.2
unnamed: C17.1, U6.38
unnamed: IC1.10, R33.1, R34.2
unnamed: IC1.5, R36.1, R37.2
unnamed: IC1.12, R39.1, R40.2
unnamed: D9.1, R29.2, R51.2, S_AL1.1
unnamed: R50.1, U6.47
unnamed: R51.1, U6.45
unnamed: R52.1, U6.42
unnamed: R53.1, U6.40
unnamed: R54.1, U6.37
unnamed: R55.1, U6.35
unnamed: SJ4.2, U6.10
unnamed: C42.1, R56.2, SJ3.1, SJ4.3, U6.16, U6.23
unnamed: C41.1, U6.27
unnamed: C43.1, U6.13
unnamed: C44.2, U6.14
unnamed: C44.1, U6.15
unnamed: R56.1, R57.2, U6.11
unnamed: C45.2, D14.C, L2.P$2, U6.50, U6.51
unnamed: C45.1, U6.52
unnamed: C48.2, R61.1, U6.2
unnamed: C47.2, R61.2
unnamed: R60.2, U6.1
unnamed: R62.1, R63.1, U6.3
unnamed: R64.1, U6.7
unnamed: IC2.1, IC2.2, R74.1
unnamed: IC2.6, IC2.7, R77.1
unnamed: IC2.8, IC2.9, R80.1
unnamed: IC2.13, IC2.14, R71.1
unnamed: IC2.3, R69.1, R70.2
unnamed: IC2.10, R72.1, R73.2
unnamed: IC2.5, R75.1, R76.2
unnamed: IC2.12, R78.1, R79.2
unnamed: R81.2, U6.26
unnamed: C56.1, U8.6
unnamed: C57.1, U7.6
PWM_A: JP1.3, U1.17
PWM_A1: JP3.3, U6.17
PWM_B: JP1.5, U1.19
PWM_B1: JP3.5, U6.19
PWM_C: JP1.7, U1.21
PWM_C1: JP3.7, U6.21
R_B: C2.2, D3.2, R3.1, R17.2, R33.2, S_BH.2, S_BH.3, S_BH.5, S_BH.6, S_BH.7, S_BL.4, U1.41, U2.1, U2.2
R_B1: C16.2, D10.2, R44.1, R58.2, R72.2, S_BH1.2, S_BH1.3, S_BH1.5, S_BH1.6, S_BH1.7, S_BL1.4, U6.41, U8.1, U8.2
R_C: C3.2, D5.2, R5.1, R18.2, R36.2, S_CH.2, S_CH.3, S_CH.5, S_CH.6, S_CH.7, S_CL.4, U1.36, U3.1, U3.2
R_C1: C17.2, D12.2, R46.1, R59.2, R75.2, S_CH1.2, S_CH1.3, S_CH1.5, S_CH1.6, S_CH1.7, S_CL1.4, U6.36, U7.1, U7.2
V+: C24.1, C25.1, C26.1, C27.1, C28.1, C29.1, C30.1, C31.1, C32.1, C33.1, C34.1, C35.1, C36.1, C37.1, C38.1, C39.1, R30.2, S_AH.4, S_BH.4, S_CH.4, U1.29, U1.53, U1.54
V+1: C58.1, C59.1, C60.1, C61.1, C62.1, C63.1, C64.1, C65.1, C66.1, C67.1, C68.1, C69.1, C70.1, C71.1, C72.1, C73.1, R69.2, S_AH1.4, S_BH1.4, S_CH1.4, U6.29, U6.53, U6.54
V-: FB1.2, R13.1, R14.1, R31.1, R34.1, R37.1, R40.1, R43.2, U1.31
V-1: FB3.2, R48.1, R49.1, R70.1, R73.1, R76.1, R79.1, R82.2, U6.31
VCC: C9.1, C12.1, L1.P$1, R21.2, U4.1, U4.3
VCC1: C46.1, C49.1, L2.P$1, R62.2, U9.1, U9.3
V_A: C18.2, JP1.11, R32.2
V_A1: C51.2, JP3.11, R71.2
V_B: C21.2, JP1.12, R41.2
V_B1: C54.2, JP3.12, R80.2
V_C: C20.2, JP1.13, R38.2
V_C1: C53.2, JP3.13, R77.2
V_LOW: C24.2, C25.2, C26.2, C27.2, C28.2, C29.2, C30.2, C31.2, C32.2, C33.2, C34.2, C35.2, C36.2, C37.2, C38.2, C39.2, D2.2, D4.2, D6.2, R2.1, R4.1, R6.1, R13.2, R14.2, S_AL.2, S_AL.3, S_AL.5, S_AL.6, S_AL.7, S_BL.2, S_BL.3, S_BL.5, S_BL.6, S_BL.7, S_CL.2, S_CL.3, S_CL.5, S_CL.6, S_CL.7, U1.30, U1.34, U1.39, U1.44
V_LOW1: C58.2, C59.2, C60.2, C61.2, C62.2, C63.2, C64.2, C65.2, C66.2, C67.2, C68.2, C69.2, C70.2, C71.2, C72.2, C73.2, D9.2, D11.2, D13.2, R29.1, R45.1, R47.1, R48.2, R49.2, S_AL1.2, S_AL1.3, S_AL1.5, S_AL1.6, S_AL1.7, S_BL1.2, S_BL1.3, S_BL1.5, S_BL1.6, S_BL1.7, S_CL1.2, S_CL1.3, S_CL1.5, S_CL1.6, S_CL1.7, U6.30, U6.34, U6.39, U6.44
V_P: C19.2, JP1.15, R35.2
V_P1: C52.2, JP3.15, R74.2
