GHF/corntroller-hw/(commit log)

2012-03-20 Initial checkin
    [MiniCob.brd, MiniCob.sch, TinyHusk.brd, TinyHusk.sch, cornMerge.brd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]
2012-03-27 Iterated TinyHusk to v2.1
    [TinyHusk.brd, TinyHusk.sch]
2012-04-02 New merged TinyHusk submitted for fab on 3/26
    [cornMerge.brd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]
2012-04-09 Change values of I_B & I_C resistor dividers
    [TinyHusk.brd, TinyHusk.sch]
2012-04-16 Iterate to v2.2; just fix silkscreen labels for PWM inputs
    [TinyHusk.brd, TinyHusk.sch]
